davidmonterocrespo24/robot_desktop/doc/animations/Ball.gif

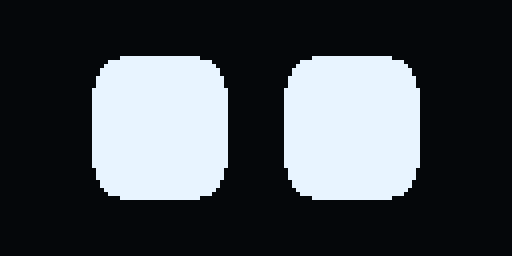
doc/animations/Ball.gif
