davidmonterocrespo24/robot_desktop/doc/animations/Bubbles.gif

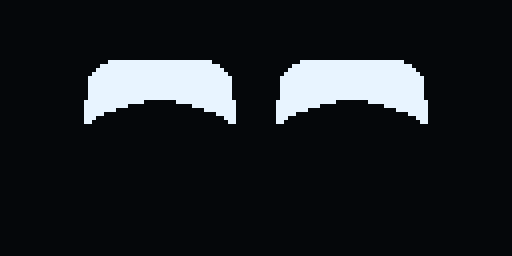
doc/animations/Bubbles.gif
