davidmonterocrespo24/robot_desktop/doc/animations/EyeRoll.gif

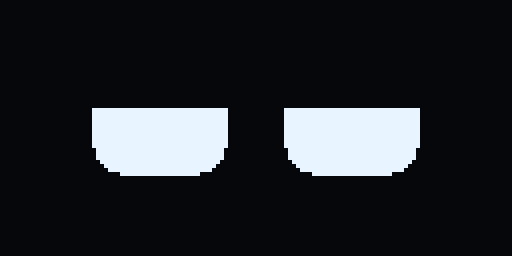
doc/animations/EyeRoll.gif
