davidmonterocrespo24/robot_desktop/doc/animations/Rain.gif

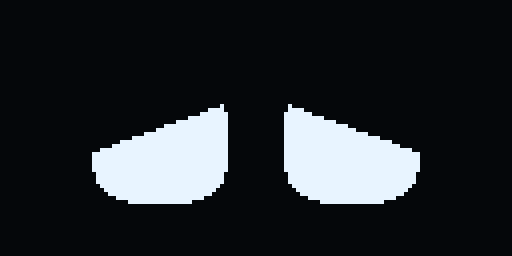
doc/animations/Rain.gif
