davidmonterocrespo24/robot_desktop/doc/animations/Read.gif

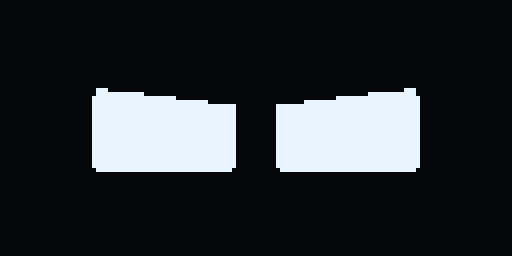
doc/animations/Read.gif
