davidmonterocrespo24/robot_desktop/doc/animations/Search.gif

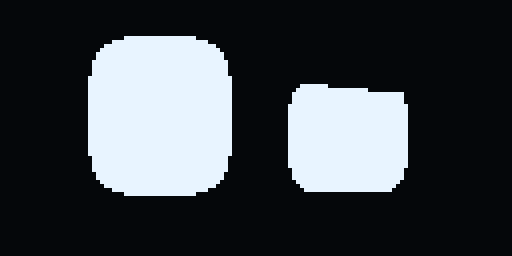
doc/animations/Search.gif
