davidmonterocrespo24/robot_desktop/doc/animations/Snore.gif

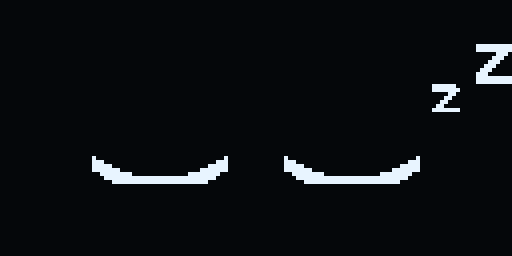
doc/animations/Snore.gif
