davidmonterocrespo24/robot_desktop/emulator/assets/robot/parts.txt

# file|role|label|triangles   (generated by tools/export_cad.py from Robot ESP32 V2 - copia.FCStd)
Part__Feature.mesh|servo_right|Gh-S37D Servo|32122
User_Library_128x64I2COLEDDisplayAdafruit.mesh|oled|User Library-128x64I2COLEDDisplayAdafruit004|8986
ESP32_DEV_KIT_V1_ASM.mesh|esp32|ESP32_DEV_KIT_V1_ASM|62417
Part__Feature061.mesh|servo_left|Gh-S37D Servo001|32122
Fusion024.mesh|leg_right|Fusion024|26198
Fusion027.mesh|leg_left|Fusion027|26432
_Unsaved_.mesh|charger|Charger)|29992
Body034.mesh|battery|Bateria|12
_Unsaved_001.mesh|dht|(Unsaved)008|16592
Body042.mesh|plate|Cuerpo042|8
Fusion033.mesh|sensor|Fusion033|1508
Fusion034.mesh|sensor|Fusion034|1508
Fusion037.mesh|shell|Fusion037|13850
Fusion040.mesh|head|Fusion040|3166
Body055.mesh|plate|Cuerpo055|12
