davidmonterocrespo24/robot_desktop/cad/ensamblado/oreja_izquierda.stl

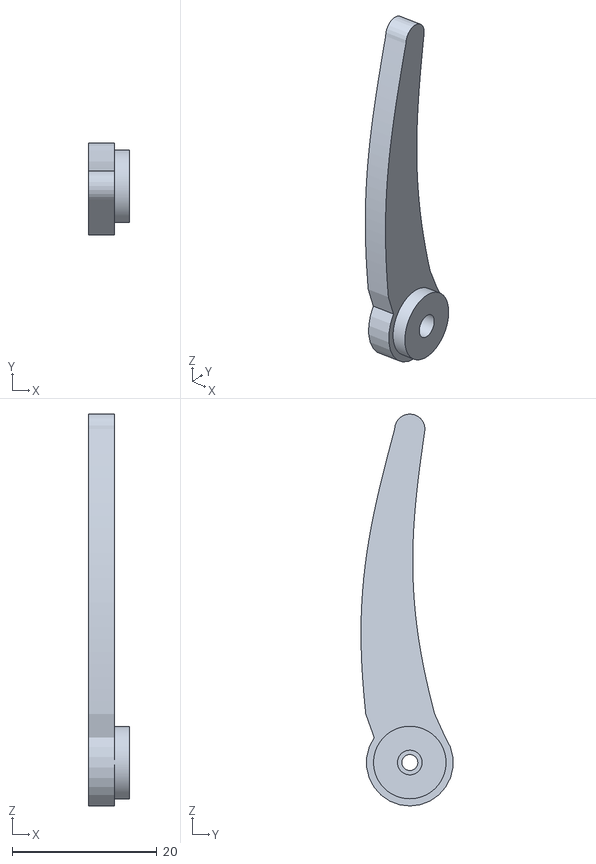
[picture p17: CAD file, 2026-11-10]
cad/ensamblado/oreja_izquierda.stl
5.70 x 12.7 x 54.1
