davidmonterocrespo24/robot_desktop/cad/esp32_eyes.step

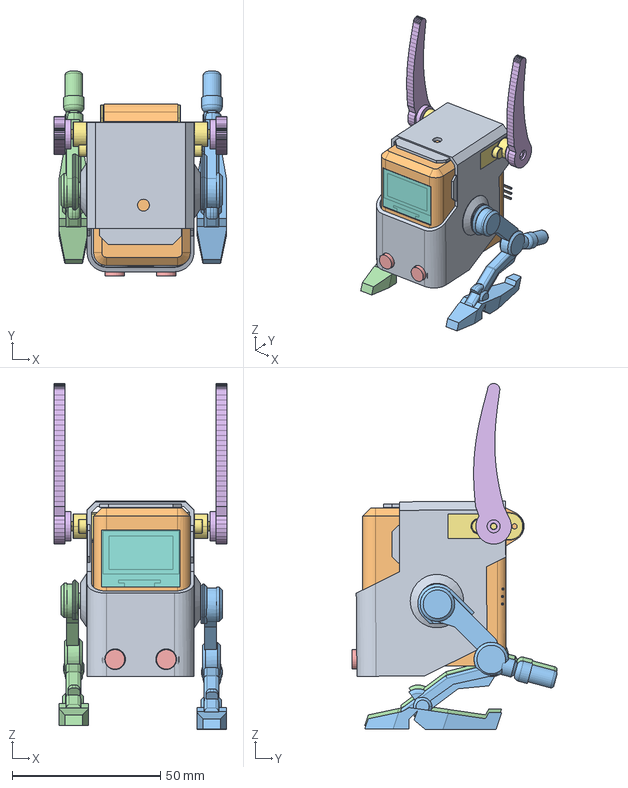
[picture p18: CAD file, 2026-11-10]
cad/esp32_eyes.step
58.2 x 69.1 x 116.5 mm
