davidmonterocrespo24/robot_desktop/cad/ensamblado/chasis.stl

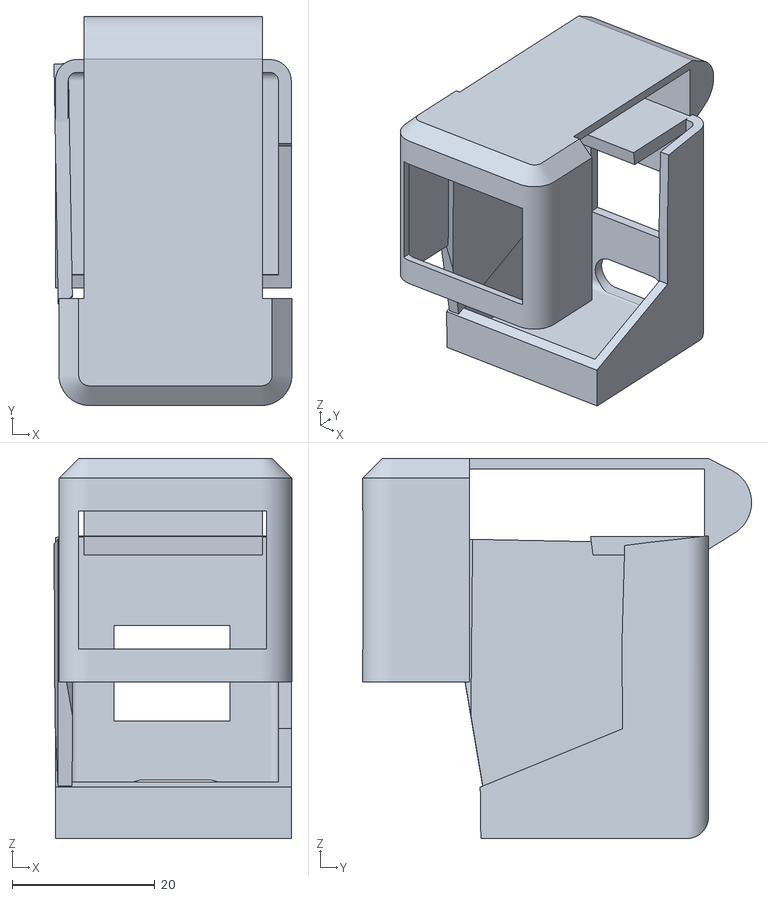
[picture p20: CAD file, 2026-11-10]
cad/ensamblado/chasis.stl
33.3 x 54.4 x 53.2
