davidmonterocrespo24/robot_desktop/cad/ensamblado/pata_izquierda.stl

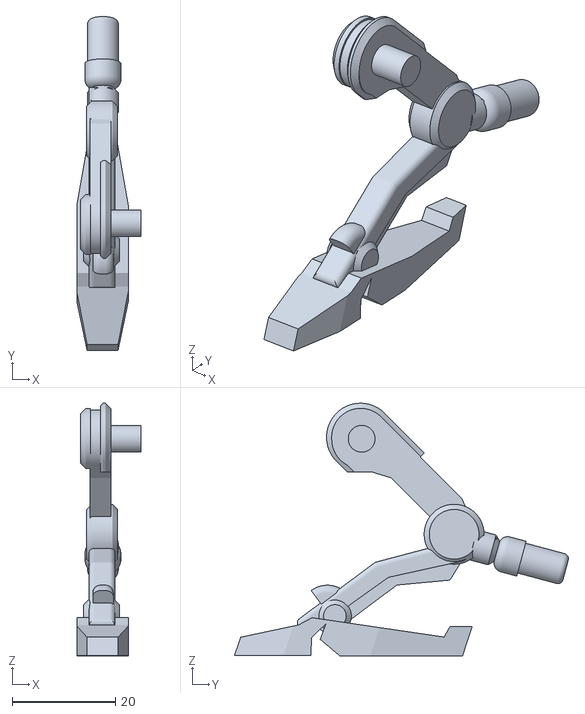
[picture p21: CAD file, 2026-11-10]
cad/ensamblado/pata_izquierda.stl
12.5 x 64.8 x 49.0
