davidmonterocrespo24/robot_desktop/cad/stl/pata_derecha.stl

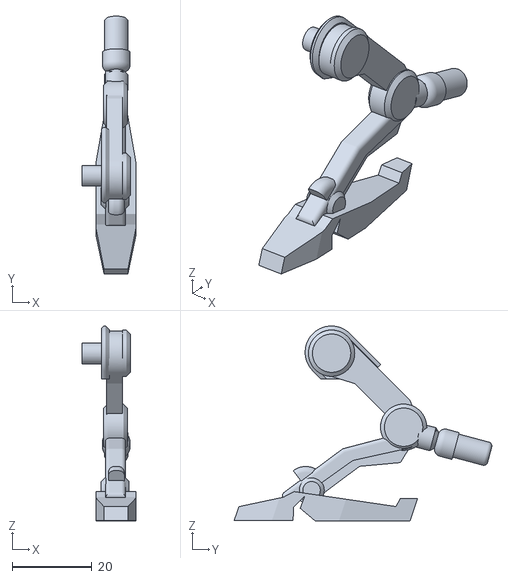
[picture p22: CAD file, 2026-11-10]
cad/stl/pata_derecha.stl
13.5 x 64.8 x 49.0
