davidmonterocrespo24/robot_desktop/cad/ensamblado/tapon_frontal.stl

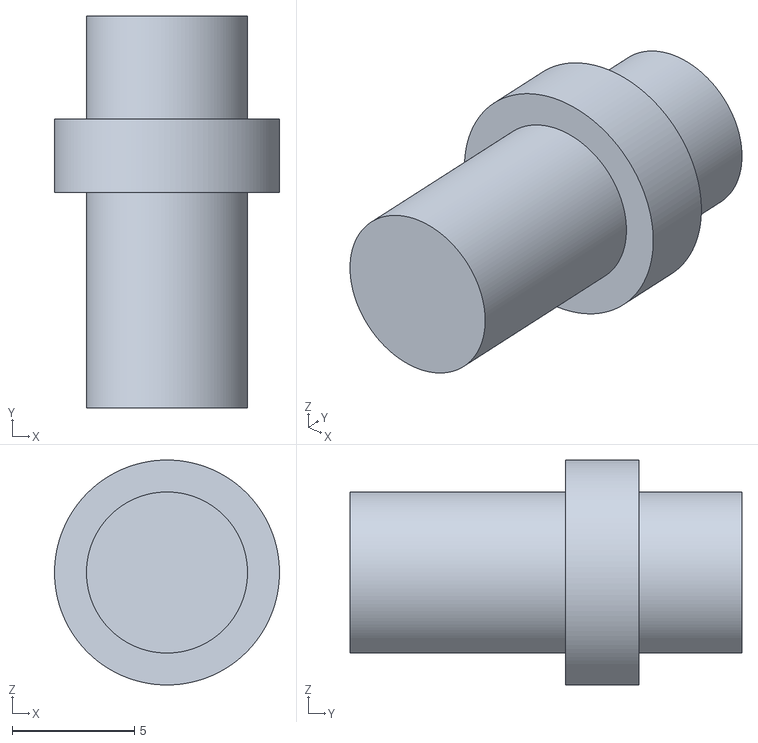
[picture p23: CAD file, 2026-11-10]
cad/ensamblado/tapon_frontal.stl
9.19 x 16.0 x 9.19
