davidmonterocrespo24/robot_desktop/cad/stl/carcasa.stl

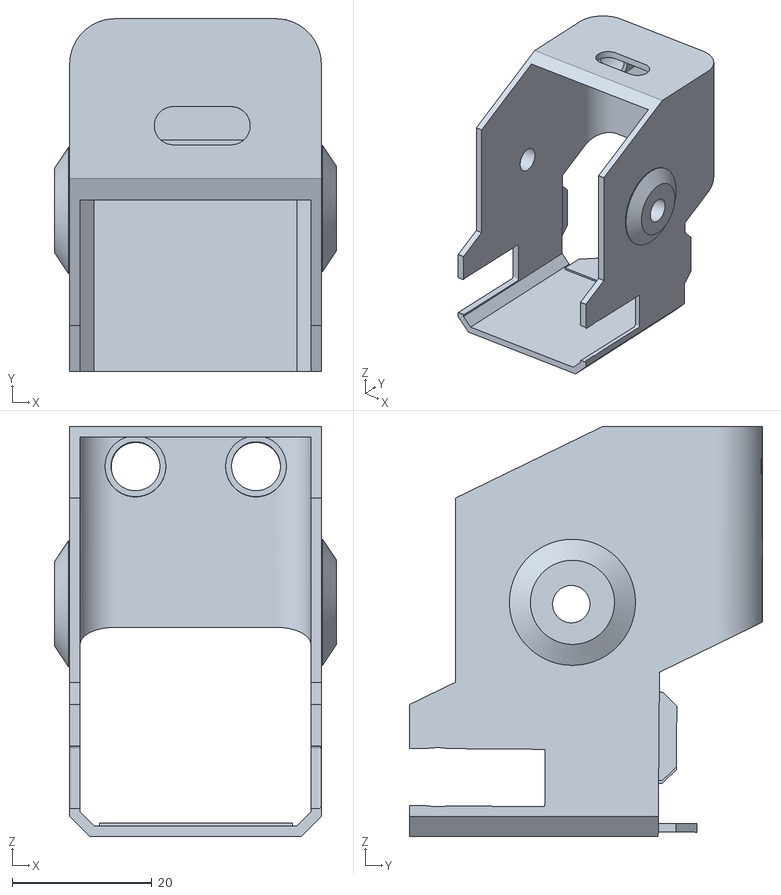
[picture p24: CAD file, 2026-11-10]
cad/stl/carcasa.stl
40.4 x 50.4 x 58.7
