davidmonterocrespo24/robot_desktop/doc/Robot ESP32 V2 - copia.FCStd

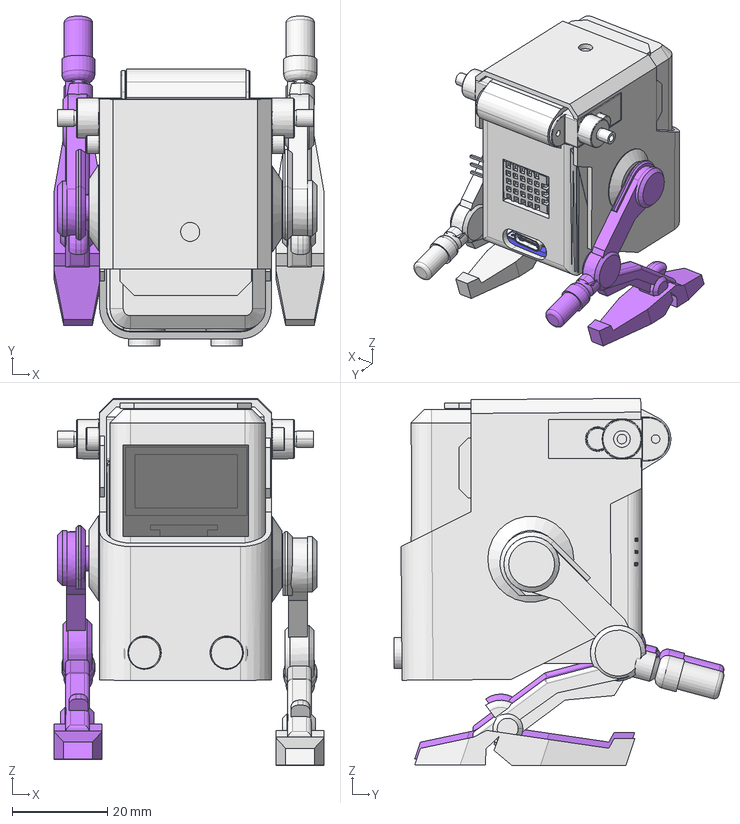
[picture p25: CAD file, 2026-11-10, an earlier design]
doc/Robot ESP32 V2 - copia.FCStd
56.5 x 69.1 x 76.9 mm
Gh-S37D Servo
User Library-128x64I2COLEDDisplayAdafruit
User Library-128x64I2COLEDDisplayAdafruit001
User Library-128x64I2COLEDDisplayAdafruit002
User Library-128x64I2COLEDDisplayAdafruit003
PCB
WIFI_CARD_2
RECTANGULARCHIP_2
MICROCHIP_2
TANCHIP_2
TRANSISTOR_3-LEG_2
RESISTOR1_2
RESISTOR1_003
RESISTOR1_004
RESISTOR1_005
RESISTOR1_006
RESISTOR2-32_2
RESISTOR2-32_003
RESISTOR1_007
RESISTOR1_008
RESISTOR1_009
RESISTOR1_010
TRANSISTOR_3-LEG2_2
RESISTOR1_011
RESISTOR1_012
BUTTONFLASH-13_2
BUTTONFLASH-14_2
BUTTONFLASH-13_003
BUTTONFLASH-14_003
USB_SOCKET_2
Gh-S37D Servo001
Shroud
Plastic Body & Connector
ATiny45_Body
ATiny45_Pin
ATiny45_Pin001
ATiny45_Pin002
ATiny45_Pin003
ATiny45_Pin004
ATiny45_Pin005
ATiny45_Pin006
ATiny45_Pin007
IC SMD 8 Pins
IC SMD 8 Pins001
IC SMD 8 Pins002
IC SMD 8 Pins003
IC SMD 8 Pins004
IC SMD 8 Pins005
IC SMD 8 Pins006
IC SMD 8 Pins007
IC SMD 8 Pins008
Pin2
Pin4
Pin6
Pin1
Pin3
Pin5
Bateria
(Unsaved)
(Unsaved)001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
