davidmonterocrespo24/robot_desktop/(list of files, cad)

Other CAD files:
cad/stl/oreja_izquierda.stl
cad/stl/oreja_derecha.stl
cad/stl/pata_izquierda.stl
cad/ensamblado/tapon_frontal_2.stl
cad/ensamblado/pata_derecha.stl
cad/stl/tapon_frontal.stl
cad/ensamblado/oreja_derecha.stl
cad/stl/chasis.stl
cad/ensamblado/carcasa.stl
