davidmonterocrespo24/robot_desktop/sound.h

#ifndef _SOUND_h
#define _SOUND_h

/***************************************************
  Project R2D2 Sound Generator

  To all fans of StarWars and Arduino!

  Written by Marcelo Larios

  BSD license, all text above must be included in any redistribution

  Participated in the Instructable Arduino Contest 2019
  https://www.instructables.com/R2D2-Sound-Generator/
****************************************************/


#define speakerPin 2
int freq = 2000;
int channel = 0;
int resolution = 8;


#define  C0 16.35
#define Db0 17.32
#define D0  18.35
#define Eb0 19.45
#define E0  20.60
#define F0  21.83
#define Gb0 23.12
#define G0  24.50
#define Ab0 25.96
#define LA0 27.50
#define Bb0 29.14
#define B0  30.87
#define C1  32.70
#define Db1 34.65
#define D1  36.71
#define Eb1 38.89
#define E1  41.20
#define F1  43.65
#define Gb1 46.25
#define G1  49.00
#define Ab1 51.91
#define LA1 55.00
#define Bb1 58.27
#define B1  61.74
#define C2  65.41
#define Db2 69.30
#define D2  73.42
#define Eb2 77.78
#define E2  82.41
#define F2  87.31
#define Gb2 92.50
#define G2  98.00
#define Ab2 103.83
#define LA2 110.00
#define Bb2 116.54
#define B2  123.47
#define C3  130.81
#define Db3 138.59
#define D3  146.83
#define Eb3 155.56
#define E3  164.81
#define F3  174.61
#define Gb3 185.00
#define G3  196.00
#define Ab3 207.65
#define LA3 220.00
#define Bb3 233.08
#define B3  246.94
#define C4  261.63
#define Db4 277.18
#define D4  293.66
#define Eb4 311.13
#define E4  329.63
#define F4  349.23
#define Gb4 369.99
#define G4  392.00
#define Ab4 415.30
#define LA4 440.00
#define Bb4 466.16
#define B4  493.88
#define C5  523.25
#define Db5 554.37
#define D5  587.33
#define Eb5 622.25
#define E5  659.26
#define F5  698.46
#define Gb5 739.99
#define G5  783.99
#define Ab5 830.61
#define LA5 880.00
#define Bb5 932.33
#define B5  987.77
#define C6  1046.50
#define Db6 1108.73
#define D6  1174.66
#define Eb6 1244.51
#define E6  1318.51
#define F6  1396.91
#define Gb6 1479.98
#define G6  1567.98
#define Ab6 1661.22
#define LA6 1760.00
#define Bb6 1864.66
#define B6  1975.53
#define C7  2093.00
#define Db7 2217.46
#define D7  2349.32
#define Eb7 2489.02
#define E7  2637.02
#define F7  2793.83
#define Gb7 2959.96
#define G7  3135.96
#define Ab7 3322.44
#define LA7 3520.01
#define Bb7 3729.31
#define B7  3951.07
#define C8  4186.01
#define Db8 4434.92
#define D8  4698.64
#define Eb8 4978.03
// DURATION OF THE NOTES 
#define BPM 120 //  you can change this value changing all the others
// I think tecnically BPM supposed to be 104, but original 120
// from instructable sounds good.  180 sounds speedy, 240 sounds mario, 300 sounds
// middle eastern, 400 middle eastern techno pop?
#define H 2*Q //half 2/4
#define Q 60000/BPM //quarter 1/4 
#define E Q/2   //eighth 1/8
#define S Q/4 // sixteenth 1/16
#define W 4*Q // whole 4/4



void phrase1()
{
    int k = random(1000, 2000);
    for (int i = 0; i <= random(100, 2000); i++)
    {
        tone(speakerPin, k + (-i * 2));
        vTaskDelay(pdMS_TO_TICKS((random(.9, 2))));
    }
    for (int i = 0; i <= random(100, 1000); i++)
    {
        tone(speakerPin, k + (i * 10));
        vTaskDelay(pdMS_TO_TICKS((random(.9, 2))));
    }
}

void phrase2()
{

    int k = random(1000, 2000);
    for (int i = 0; i <= random(100, 2000); i++)
    {
        tone(speakerPin, k + (i * 2));
        vTaskDelay(pdMS_TO_TICKS((random(.9, 2))));
    }
    for (int i = 0; i <= random(100, 1000); i++)
    {
        tone(speakerPin, k + (-i * 10));
        vTaskDelay(pdMS_TO_TICKS((random(.9, 2))));
    }
}

void playerTone()
{
    int K = 2000;
    switch (random(1, 7))
    {
    case 1:
        phrase1();
        break;
    case 2:
        phrase2();
        break;
    case 3:
        phrase1();
        phrase2();
        break;
    case 4:
        phrase1();
        phrase2();
        phrase1();
        break;
    case 5:
        phrase1();
        phrase2();
        phrase1();
        phrase2();
        phrase1();
        break;
    case 6:
        phrase2();
        phrase1();
        phrase2();
        break;
    }
    for (int i = 0; i <= random(3, 9); i++)
    {
        tone(speakerPin, K + random(-1700, 2000));
        vTaskDelay(pdMS_TO_TICKS((random(70, 170))));
        noTone(speakerPin);
        vTaskDelay(pdMS_TO_TICKS((random(0, 30))));
    }
    noTone(speakerPin);
    vTaskDelay(pdMS_TO_TICKS((random(2000, 4000))));
}



void mytone(int freq, int duration) {
  ledcWriteTone(channel, freq);
  vTaskDelay(pdMS_TO_TICKS((duration)));
  ledcWriteTone(channel, 0);
}
 
void StarWars() { 
  ledcSetup(channel, freq, resolution);
  ledcAttachPin(speakerPin, channel);
 }
 
void StarWarsPlay() {
  //mytone(note, duration)
    mytone(LA3,Q); 
    mytone(LA3,Q);
    mytone(LA3,Q);
    mytone(F3,E+S);
    mytone(C4,S);
    
    mytone(LA3,Q);
    mytone(F3,E+S);
    mytone(C4,S);
    mytone(LA3,H);
    
    mytone(E4,Q); 
    mytone(E4,Q);
    mytone(E4,Q);
    mytone(F4,E+S);
    mytone(C4,S);
    
    mytone(Ab3,Q);
    mytone(F3,E+S);
    mytone(C4,S);
    mytone(LA3,H);
    
    mytone(LA4,Q);
    mytone(LA3,E+S);
    mytone(LA3,S);
    mytone(LA4,Q);
    mytone(Ab4,E+S);
    mytone(G4,S);
    
    mytone(Gb4,S);
    mytone(E4,S);
    mytone(F4,E);
    vTaskDelay(pdMS_TO_TICKS((E)));//PAUSE
    mytone(Bb3,E);
    mytone(Eb4,Q);
    mytone(D4,E+S);
    mytone(Db4,S);
    
    mytone(C4,S);
    mytone(B3,S);
    mytone(C4,E);
    vTaskDelay(pdMS_TO_TICKS((E)));//PAUSE QUASI FINE RIGA
    mytone(F3,E);
    mytone(Ab3,Q);
    mytone(F3,E+S);
    mytone(LA3,S);
  
    mytone(C4,Q);
    mytone(LA3,E+S);
    mytone(C4,S);
    mytone(E4,H);
    
    mytone(LA4,Q);
    mytone(LA3,E+S);
    mytone(LA3,S);
    mytone(LA4,Q);
    mytone(Ab4,E+S);
    mytone(G4,S);
    
    mytone(Gb4,S);
    mytone(E4,S);
    mytone(F4,E);
    vTaskDelay(pdMS_TO_TICKS((E)));//PAUSE
    mytone(Bb3,E);
    mytone(Eb4,Q);
    mytone(D4,E+S);
    mytone(Db4,S);
    
    mytone(C4,S);
    mytone(B3,S);
    mytone(C4,E);
    vTaskDelay(pdMS_TO_TICKS((E)));//PAUSE QUASI FINE RIGA
    mytone(F3,E);
    mytone(Ab3,Q);
    mytone(F3,E+S);
    mytone(C4,S);
    
    mytone(LA3,Q);
    mytone(F3,E+S);
    mytone(C4,S);
    mytone(LA3,H);
    
    vTaskDelay(pdMS_TO_TICKS((2*H)));
}

void vSoundTask(void *pvParameters)
{
    while (1)
    {
        playerTone();
        vTaskDelay(pdMS_TO_TICKS(random(60000, 600000)));
    }
}


#endif
