davidmonterocrespo24/robot_desktop/Face.cpp

/***************************************************
Copyright (c) 2020 Luis Llamas
(www.luisllamas.es)

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
This program is distributed in the hope that it will be useful, but WITHOUT ANY WARRANTY; without even the implied warranty of MERCHANTABILITY or FITNESS FOR A PARTICULAR PURPOSE.  See the GNU Affero General Public License for more details.

You should have received a copy of the GNU Affero General Public License along with this program.  If not, see <http://www.gnu.org/licenses 
****************************************************/


#include "Face.h"
#include "Common.h"

U8G2_SSD1306_128X64_NONAME_F_HW_I2C u8g2(U8G2_R0, /* reset=*/ U8X8_PIN_NONE);


Face::Face(uint16_t screenWidth, uint16_t screenHeight, uint16_t eyeSize) 
	: LeftEye(*this), RightEye(*this), Blink(*this), Look(*this), Behavior(*this), Expression(*this) {

  // Unlike almost every other Arduino library (and the I2C address scanner script etc.)
  // u8g2 uses 8-bit I2C address, so we shift the 7-bit address left by one

  u8g2.begin();
  u8g2.clearBuffer();

	Width = screenWidth;
	Height = screenHeight;
	EyeSize = eyeSize;

	CenterX = Width / 2;
	CenterY = Height / 2;

	LeftEye.IsMirrored = true;
  /*int progress =0;
  while (progress < 108)
  {
    u8g2.clearBuffer();
    u8g2.drawStr(25, 50, "Hola, Soy Didi...");
    u8g2.drawFrame(0, 10, 128, 20);
    u8g2.drawBox(10, 15, progress, 10);
    progress++;
    u8g2.sendBuffer();
    delay(10);
  }
  delay(1000);*/
  Behavior.Clear();
	Behavior.Timer.Start();
}

void Face::LookFront() {
	Look.LookAt(0.0, 0.0);
}

void Face::LookRight() {
	Look.LookAt(-1.0, 0.0);
}

void Face::LookLeft() {
	Look.LookAt(1.0, 0.0);
}

void Face::LookTop() {
	Look.LookAt(0.0, 1.0);
}

void Face::LookBottom() {
	Look.LookAt(0.0, -1.0);
}

void Face::Wait(unsigned long milliseconds) {
	unsigned long start;
	start = millis();
	while (millis() - start < milliseconds) {
		Draw();
	}
}

void Face::DoBlink() {
	Blink.Blink();
}

void Face::Update() {
	if(RandomBehavior) Behavior.Update();
	if(RandomLook) Look.Update();
	if(RandomBlink)	Blink.Update();
	Draw();
}

void drawZ(U8G2 &u8g2, int startX, int startY) {
  u8g2.drawLine(startX, startY, startX + 20, startY);
  u8g2.drawLine(startX + 20, startY, startX, startY + 20);
  u8g2.drawLine(startX, startY + 20, startX + 20, startY + 20);
}


void Face::Draw() {
  // Clear the display
  u8g2.clearBuffer();
  // Draw left eye
	LeftEye.CenterX = CenterX - EyeSize / 2 - EyeInterDistance;
	LeftEye.CenterY = CenterY;
	LeftEye.Draw();
  // Draw right eye
	RightEye.CenterX = CenterX + EyeSize / 2 + EyeInterDistance;
	RightEye.CenterY = CenterY;
	RightEye.Draw();
  // Transfer the redrawn buffer to the display
    u8g2.sendBuffer();
}
