davidmonterocrespo24/robot_desktop/(commit log)

2026-11-10 Rewrite: new face engine, emulator with 3D view, CAD export and documentation
    - src/: face engine (expressions, emotion graph, acts, decorations), brain state machine,
    sensors, ears and buzzer; the previous code moved to legacy/
    - emulator/: Windows emulator (raylib) with the 3D model of the robot, the state machine
    view and scripted runs; facetool for sheets and GIFs
    - tools/: CAD export (FreeCAD) and GIF-to-clip converter
    - doc/: wiring guide, state machine, the FreeCAD models, expressions and animations
    [Robot ESP32 V2 - copia.FCStd, Robot ESP32 V2.FCStd]
2026-11-10 Print files: STL of every printed part in print position, new ears for the GH-S37D, STEP of the whole robot, assembly guide
    [carcasa.stl, chasis.stl, esp32_eyes.step, oreja_derecha.stl, oreja_izquierda.stl, pata_derecha.stl, pata_izquierda.stl, tapon_frontal.stl]
